aethanC1/LNA_board/Final Project Write Up.pdf

ECED 4460 Project Report
Low Noise Amplifier Design Using Planar TL Structures

Wrien By:
Benjamin Jarrin (B00846633) Aethan Cubi (B00877256)

Submied To:
Dr. David Chen
Dalhousie University
Halifax, Nova Scoa
25/04/2024

1

Objecve
Our objecve is to design a low-noise amplifier for a frequency of around 2.4GHz. This design is meant to be completed using a biasing network to bias the amplifying transistor. The second major component of the design is to use input and output matching networks to balance the impedances from the source and load into the amplifier. The outcome of this project will be a PCB board that will amplify a real RF signal.

Design Descripon
The low-noise amplifier in this project is meant to follow some design specificaons and meet the targets summarized in Table 1.

Table 1: Required Amplifier Parameters

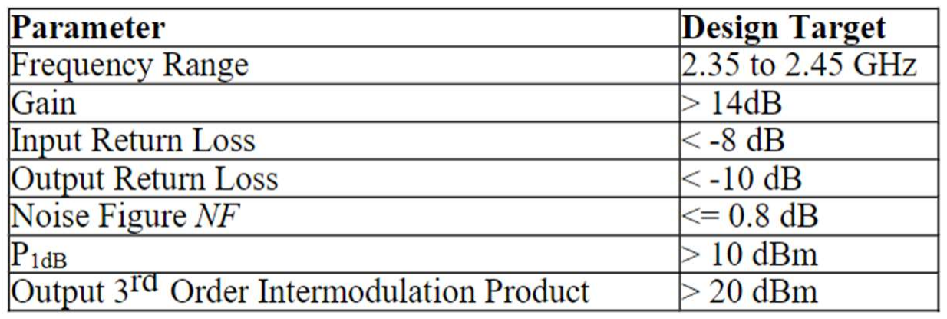
[picture p1: figure]

As Table 1 shows, the amplifier needs to have a gain of at least 14 dB. Each of these targets has been taken into consideraon in the final design by using the procedure learned in class. For this project the source, load, and characterisc impedance will be 50Ω.
The low-noise amplifier uses a SKY65050-372 n-channel transistor manufactured by SKYWORKS. The general block diagram of the system has been included in Figure 1 below.

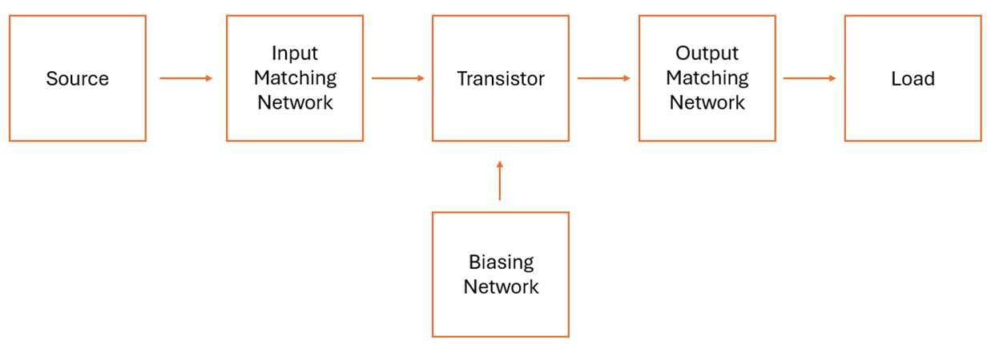
[picture p2: figure]

Figure 1: Amplifier Block Diagram
As seen in Figure 1, the transistor is the main component of the system as it is what generates the amplificaon. The source will generate the RF signal at 2.4GHz; the input matching network (IMN) then needs to convert the source impedance into a value that will result in the parameters being met. Similarly, the output matching network (OMN) will convert the load impedance into a desired value to meet the design target. Finally, the biasing network will be

2

designed to bias the transistor to its acve region and to a desired drain-source voltage and current.
The circuit schemacs which show the components of the amplifier more in detail have been included in Figure 2 below.

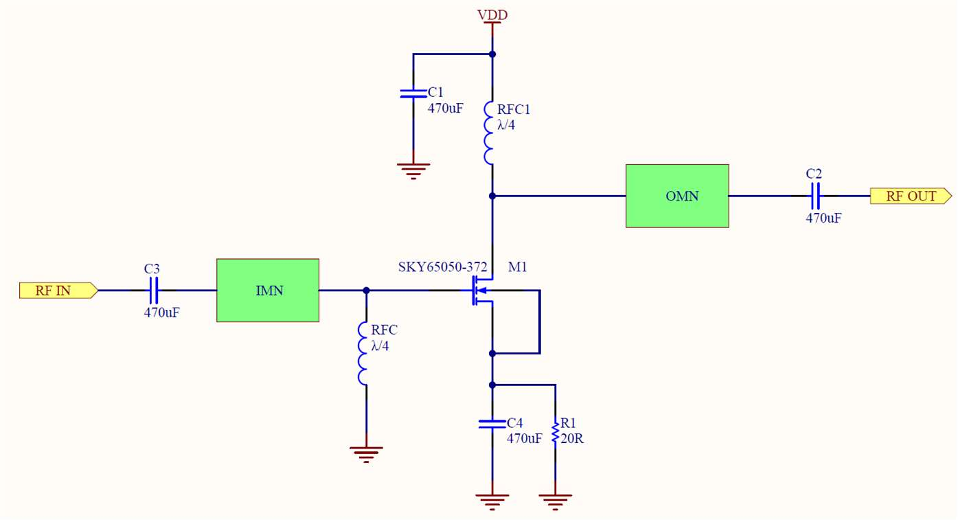
[picture p3: figure]

Figure 2: Amplifier Circuit Schemacs
In the schemacs above, the IMN, OMN, and RFC are replaced by microstrip transmission lines in the actual implementaon.
The value of VDD for this system has to be 4.3V, this will ensure that the transistor is biased to the desired condions. The funcon of the 20Ω resistor “R1” is to control the drain current into the desired value of 20mA. The funcon of the RFC is to let the DC current pass for biasing purposes while blocking the 2.4GHz RF signal. Finally, the capacitors have the funcon of decoupling, acng as AC ground, and blocking DC current.
For the design process, it was decided to aim for a target transducer gain of 18 dB. This was considered to be a good value as it was not in the lower limit, and it would result in an appropriate noise figure for the system.
ADS was used to aid in the design and opmizaon of the circuit. It was ulized to determine the exact biasing current of the transistor based on the transistor S parameters and biasing components.
Once the inial matching parameters were used, the IMN and OMN were added as microstrip lines to the design. The rest of the inial design that was in component form was redesigned into microstrip lines. The opmizaon goals were then set and the circuit was opmized.
Once the opmized circuit was created, the layout and symbol was created, following by adding a ground plane, vias, and lengths to add the input and output connector.

3

The symbol was then created into a Gerber file and sent into the technicians.

Procedures and Methodology
The design procedure started with the calculaon of the unilateral figure of the transistor using the MATLAB code in Appendix A. The calculaons revealed that a unilateral design was not possible which meant that another method had to be chosen. Aer consideraon of the different available opons, it was decided that the Available Power Gain method would be used as it allows one to choose a desired gain value and it does not have a unique soluon. This means that this method allows the choice of the most convenient value for the impedances to be matched based on other design parameters.
To have an organized approach, the design flow chart learned in class was used to design the amplifier. To determine whether the transistor is uncondionally stable, the proper calculaons were performed using the MATLAB code in Appendix A. The results were that it was not uncondionally stable, so the stability circles were calculated and ploed. Then, the noise consideraons were analyzed. The requirements were for a noise figure of less than 0.8 dB, so the MATLAB code in Appendix A was used to plot this noise circle. With the selected values, the calculated Noise Figure was 0.63 dB which is less than the maximum of 0.8 dB. Next, the available power gain method was used to plot the constant VSWR circle for a gain of 18 dB using the MATLAB code in Appendix A.
With all the parameters, the Smith chart in Figure 3 was obtained where the red circle is output stability, the green circle is the available power gain circle for a gain of 18 dB, and the pink circle is the noise circle.

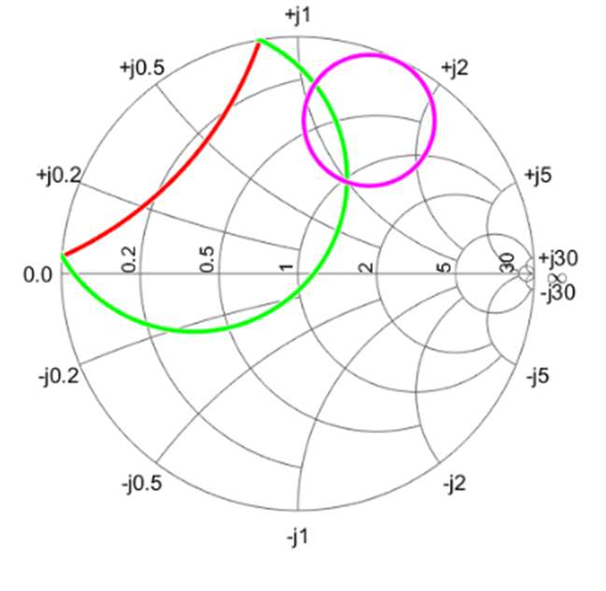
[picture p4: figure]

Figure 3: Smith Chart For IMN from MATLAB
This chart was also ploed in ADS using the simulaon feature to have more accurate results. The biasing network was created in ADS with ideal DC and AC blocks to create an output simulaon from the S-parameters and biasing network. From this (Appendix C), it was decided

4

that a good value for the input impedance which sasfies all the parameters was Zs = 0.6+j1.47. This means that the IMN will have to match the source impedance to the normalized value stated before.
From the Smith chart, the value of the source reflecon coefficient was measured which through the code in Appendix A allowed us to determine that the value for the load impedance would have to be Zl = 0.9774+j0.9215. This means that the OMN will have to transform the value of the normalized load impedance to the value menoned before. This point was also ploed in the Smith chart with the output stability circle to ensure the system remained stable, which it was.
The next step was to design the IMN and the OMN. The MATLAB code in Appendix A and the hand calculaons in Appendix B were used to obtain the matching networks.

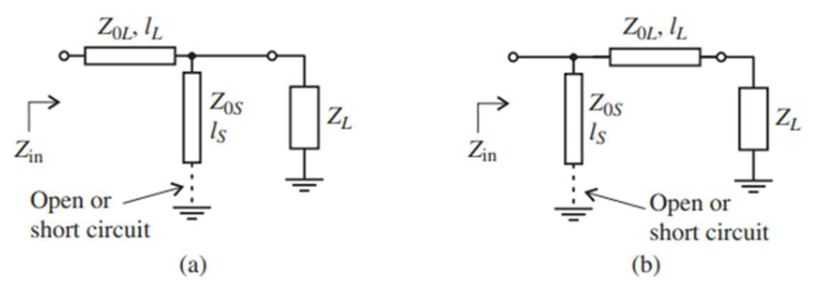
[picture p5: figure]

Figure 4: Microstrip Matching Networks Configuraons
For the IMN, configuraon b) of Figure 4 was used, while for the OMN configuraon a) was used. The purpose of this was to have the stubs as far as possible of the RFCs which would be close to the transistor. It was calculated that the length lL=3.425 cm and the length ls=0.924cm. Furthermore, it was chosen for ls to be short-circuited to have a shorter stub and to keep the integrity of the RF signal by allowing it to go to ground. For the OMN, IL=3.173cm, and ls=1.674cm. Similarly, the stub was chosen to be short-circuited to have a shorter stub and for signal integrity.
Finally, a non-linear analysis was performed using the MATLAB code in Appendix A to assess the last requirements which include intermodulaon distoron, harmonics, and gain compression. Since this amplifier consists only of one stage, the values for P1dB and IP3out are those of the first and only stage. These values are P1dB = 10.5 dBm and IP3out = 23.5 dBm which are higher than the minimum values. Furthermore, it was calculated that the dynamic range dR = 64.88 dB and the free spurious dynamic range df = 51.92 dB. Since the amplifier was designed for a gain of 18 dB, this means that the design would be operang within the linear region and intermodulaon distoron would not affect the output.

5

Implementaon and Measurements
The calculated Zs and ZL parameters were then implemented into the line calculaon feature in ADS. The network shown in Appendix C is the network created from these values. The opmizaon of the circuit through the goals in Appendix C changed the IMN lengths to lL= 2.742 cm and ls=0.493 cm. The opmizaon goals also changed the OMN lengths to IL=2.9235 cm, and ls=2.659 cm.
In addion, the transion from a theorecal circuit to a real microstrip line circuit resulted in capacitors being added between each stub end and ground except the input quarter wavelength stub. This is to create an AC ground across the capacitors.
The transistor was the main component being added to the board. This requires building the pads from the data sheet on ADS and providing the appropriate gaps for the component to be soldered onto the board. The gap measurements for all parts were measured out based on the gap sizes of the resistors and capacitors. The resistors and capacitors were chosen based on the size in stock and the impedances available. These were then implemented into the circuit with gaps and pads for the components.
Once the amplifier values where calculated and the PCB design was performed using ADS, the PCB was printed. Then, the discrete components like the transistor and capacitors were soldered into the board. A photo of the final physical product has been included in Figure 5 below.

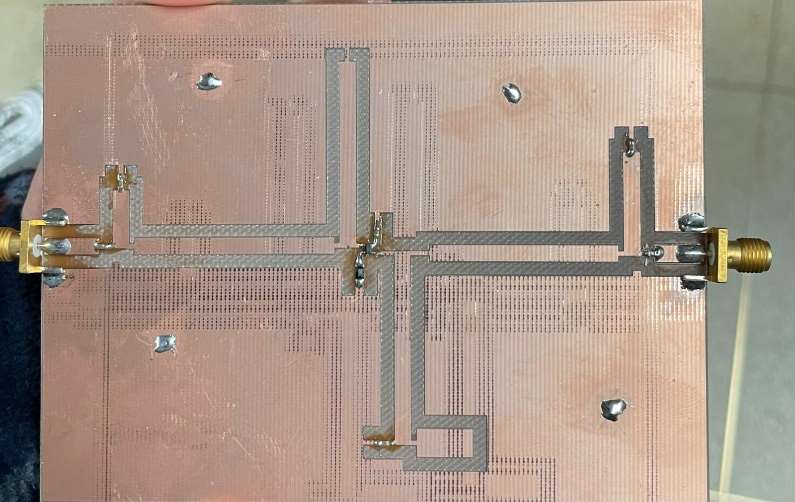
[picture p6: figure]

Figure 5: Final Physical Product
On the tesng day, the circuit was tested in a lab environment using a special signal generator and oscilloscope to measure the frequency response of the amplifier with respect to S21 (gain), and S11 (input return loss) within a range of frequencies from 0.3MHz to 8.5GHz. Furthermore, the circuit was biased to 4.3 VDC with a DC power supply.

6

Aer tesng, the data was gathered and the graphs generated have been included in the figures below.

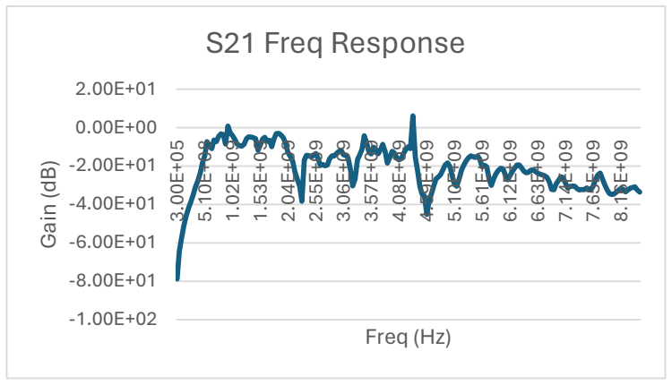
[picture p7: figure]
Freq (Hz); S21 Freq Response

Figure 6: S21 Frequency Response

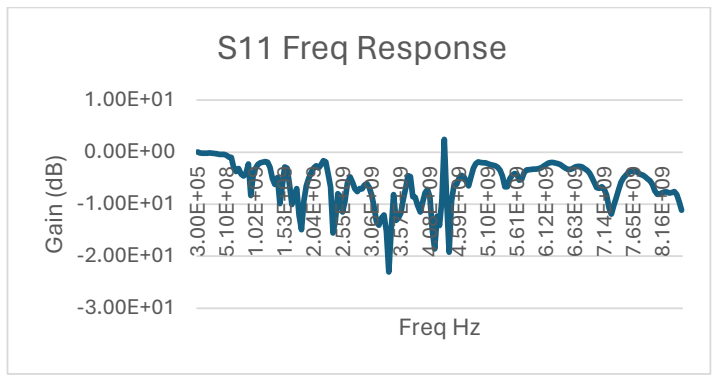
[picture p8: figure]
Freq Hz; S11 Freq Response

Figure 7: S11 Frequency Response
As seen in figure 6, the graph for the gain (S21) shows that in the design target frequency range of 2.35 to 2.45 GHz the gain is a negave dB value. This means that in the linear scale, the gain was less than 1 and greater than zero which means that the RF signal was aenuated instead of amplified. However, the graph shows that for a frequency of 4.34 GHz, the RF signal experienced a gain of 6.15 dB. These results were unexpected because the amplifier was designed to produce a gain at a frequency of 2.4 GHz, but the actual results showed there was no amplificaon at this frequency and there was at 4.34 GHz. The possible reasons for this behavior will be discussed in the next secon.
As seen in figure 7, the graph for the input return loss (S11) reveals that this parameter has a negave dB value throughout the target design frequency range of 2.35 to 2.45 GHz. The data also shows that at a frequency of 2.47 GHz S11 = -8 dB and at a frequency of 2.51 GHz
S11 = -8.52 dB which means that the requirement for the input return loss was achieved at frequencies very close to the target 2.4GHz.

2.00E+01 3.00E+05 5.10E+08 1.02E+09 1.53E+09 2.04E+09 2.55E+09 3.06E+09 3.57E+09 4.08E+09 4.59E+09 5.10E+09 5.61E+09 6.12E+09 6.63E+09 7.14E+09 7.65E+09 8.16E+09 Gain ⁽dB⁾

1.00E+01 Gain ⁽dB⁾ | 3.00E+05 5.10E+08 1.02E+09 1.53E+09 2.04E+09 2.55E+09 3.06E+09 3.57E+09 4.08E+09 4.59E+09 5.10E+09 5.61E+09 6.12E+09 6.63E+09 7.14E+09 7.65E+09 8.16E+09

7

Analysis
As it was discussed in the implementaon and measurement secon, the final design and tesng did not yield the results expected in terms of gain. For the desired operang frequency of 2.4GHz, the RF signal was aenuated instead of amplified. Furthermore, there was an amplificaon of 6.15 dB at a frequency of 4.34 GHz. There could have been mulple factors that led to the deviaon between the theorecal values and real results. Firstly, it is not believed that the deviaons were due to a biasing issue. This is because when tesng the circuit, the voltage between the gate and the source of the MOSFET was close to 3VDC which was what it was designed for. Furthermore, the biasing voltage was swept across a range of acceptable values without having any success in achieving the desired gain values.
Aer ruling out the biasing as a possible cause of the inability to obtain the desired gain, it is hypothesized that the reason for this could have been a combinaon of the matching network design and the PCB design for RF signal integrity. There is a possibility there was a mistake in the design of the matching networks when using the MATLAB code in Appendix A or the hand calculaons in Appendix B. If a major mistake was made in the design of the matching networks, this means that the input and output impedances required for the transistor to generate the desired gain were not achieved and another value for the gain was obtained. This could also explain why there was gain observed at 4.34GHz instead of 2.4GHz.
The second possible reason has to do with the design of the PCB. RF design is a complex subject as the PCB needs to have mulple consideraons for signal integrity. These factors include shielding along the RF signal traces and mulple vias in the ground plane. Both of these are done to preserve the quality of the RF signal. Due to the learning stage we are at, these other consideraons were not taken into account. As a result, the RF signal was not correctly handled in the PCB leading to scaering and addional aenuaon within the board.
Another hypothecal reason could be the secons added to the board to accept the SMA connectors did not take into account the wavelength of the input frequency. This shortcoming and misunderstanding of how the input and output interact with the circuit was a highly probable reason for the circuit not performing. In the next iteraon of the board we would aach the LNA to be on a wavelength stub to ensure that an integral signal is being input onto the board.
This change would change the length of the connecng stub to 12 mm to 0 mm. By aaching the SMA connector directly to the end of the circuit the wavelength will be inserted without inserng an inaccuracy which un-validated the matching network.
Another improvement in the next iteraon of the circuit would be the removal of the extra connecng lines between stubs. The most accurate way to connect each component of the

8

network is to have them T up directly next to eachother. In the circuit designed we had a space with a thin wire connecng the components, this wire may have brought unforeseen error to our circuit.
The last main component that was missing from the constructed PCB was the fact that we were unable to achieve a simulated gain of more than 8dB. The simulaons outcome from the opmizaons didn’t allow for us to be able to simulate the correct gain. The theorecal gain was calculated to be 18dB but did not match ADS. To fix this error we would allow more components of the circuit to be modified to hopefully allow ADS to achieve a posive gain. Another possible soluon to these problems would be to modify the weights or goals themselves more than what has already been changed.

Conclusion
The design of an LNA board is complicated, but also an amazing learning experience. We learned the power of ADS and how it can be applied to help create a gain, but with powerful compung comes complexity. The difference between our theorecal circuit, gains, ADS, and the tested circuit board posed different challenges along the way. We believe we did accurate inial calculaons of the circuit, and in the next iteraon would put a larger focus and more me on the fine tuning within the ADS soware. The key findings of the circuit are shown below.

Table 2: Final Results
| Goal | Achieved
Biasing Voltage | 3.0V | 3.2V
Biasing Current | 20mA | 20mA +- 5mA
S11 | -8 dB < | -8.52 dB
Gain at 4.3 GHz | | 6.15 dB

The low noise amplifier design procedure was followed to achieve an amplifier based on theorecal calculaons. The final product was achieved by designing a DC biasing network, stability network design, impedance matching network design, layout, ADS simulaons and opmizaons, nonlinear analysis, Gerber file generaon, prototype building, and tesng and verificaon of the final results.
Even though the final product did not achieve the final amplificaon objecves, the process involved in designing the amplifier was extremely valuable to understanding the process and theory learned in class through its applicaon. This process also was valuable in the development of crical thinking skills and problem-solving through creavity and the use of theorecal concepts.

9

Finally, both group members contributed equally to the contribuon of the project. Tasks were divided equally to make sure understanding of the topics were achieved and collaboraon was crual to achieve the final design.

Appendix A: MATLAB Code

%Transistor Parameters
%Freq=2.393675GHz
clc
clear all
disp(['Transistor Parameters']) s11dBmag=-2.86;
s11dBph=-108.74;
s12dBmag=-25.24;
s12dBph=26.54;
s21dBmag=15.58;
s21dBph=91.14;
s22dBmag=-3.21;
s22dBph=-52.01:;
s11 = 10^(s11dBmag/20)*exp(s11dBph/180 * pi* 1i); % Convert from dB to linear scale s12 = 10^(s12dBmag/20)*exp(s12dBph/180 * pi * 1i);
s21 = 10^(s21dBmag/20)*exp(s21dBph/180 * pi * 1i);
s22 = 10^(s22dBmag/20)*exp(s22dBph/180 * pi * 1i);
disp(['s11 = ', num2str(abs(s11)), '<', num2str(angle(s11)*180/pi)]) disp(['s12 = ', num2str(abs(s12)), '<', num2str(angle(s12)*180/pi)]) disp(['s21 = ', num2str(abs(s21)), '<', num2str(angle(s21)*180/pi)]) disp(['s22 = ', num2str(abs(s22)), '<', num2str(angle(s22)*180/pi)])
delta = ((s11*s22) - (s12 * s21)); %complex
k = (1 - abs(s11*s11) - abs(s22 * s22) + abs(delta * delta))/(2 * abs(s12*s21));

%Unilateral Design Check
disp(['Unilateral design considerations'])
GTU = 18;
U = (abs(s12*s21*s11*s22))/((1-abs(s11^2))*(1-abs(s22^2))); MD = 1/(1+U)^2;
LD = 1/(1-U)^2;
MDdB = 10*log10(MD);
LDdB = 10*log10(LD);
Lessval = (MDdB/GTU)*100
Plusval = (LDdB/GTU)*100
%Stability Considerations
%For Output Stability
disp(['Stability Considerations'])
Cout = (conj(s22 - conj(s11)*delta))/ (abs(s22 * s22) - abs(delta * delta)); Coutmag = abs(Cout)
Coutph = angle(Cout)*180/pi
Coutc = [(real(Cout)), (imag(Cout))];
rout = abs(s12 * s21)/ ( abs(abs(s22 * s22) - abs(delta * delta))) %For Input Stability

10

Cin = (conj(s11 - conj(s22)*delta))/ (abs(s11 * s11) - abs(delta * delta)); Cinmag = abs(Cin)
Cinph = angle(Cin)*180/pi
Cinc = [real(Cin), imag(Cin)];
rin = abs(s12 * s21)/ ( abs(abs(s11 * s11) - abs(delta * delta)))

%Available Power Gain Method
disp(['Available Power Gain Method'])
GAdB = 18; %Target gain in dB
GA = 10^(GAdB/10); %Target gain in linear scale
ga = GA/(abs(s21))^2;
dga = (ga*conj(s11-(delta*conj(s22))))/(1+(ga*(abs(s11*s11)-abs(delta*delta)))); dgac = [real(dga), imag(dga)];
numrga = sqrt(1-(2*k*ga*abs(s12*s21))+(ga*ga*(abs(s12*s21))^2));
denrga = abs(1+(ga*(abs(s11*s11)-abs(delta*delta))));
disp(['dga = ', num2str(abs(dga)), '<', num2str(angle(dga)*180/pi)]) rga = numrga/denrga

%Noise Figure Code
Gsmag=0.7 %insert magnitude of gammaS
Gsphase=60.28 %insert phase of gammaS in deg Gs = Gsmag*exp(1i*deg2rad(Gsphase));
Goptmag = 0.745;
Goptph = 65;
Gopt = 10^(Goptmag/20)*exp(Goptph/180 * pi* 1i) Fmin = 10^(0.39/10); %dB
Rn = 8; %this gets divided by 50 to become 0.16
Zo = 50;
F = (Fmin + (4 * Rn / Zo) * (abs((Gs-Gopt)*(Gs-Gopt))) / ((1-abs(Gs * Gs)) * (abs(1+Gopt))*(abs(1+Gopt))));
NF = 10 * log10(F) %should be less than 0.8
Fk = 10^(0.8/10);
Qk = (abs(1 + Gopt) * abs(1 + Gopt)) * (Fk-Fmin)/(4 * Rn / Zo); % Where in circle dfk = Gopt/(1 + Qk) %Center of Circle
df = [real(dfk), imag(dfk)];
rfk = sqrt(((1-(abs(Gopt))^2)*Qk)+Qk^2)/(1+Qk)

%Biasing Calculations
syms Rs
VDS=3; %volts
ID = 0.02; %in Amps
Vth = -0.8; %in volts
gm = 0.08; %in S
EQ = (ID*ID*Rs^2)+(2*Vth*ID*Rs)+((Vth^2)-((4*ID^2)/(gm^2))) R1=solve(EQ)
VDD = VDS+(R1(1)*ID)

%plotting circles on smith chart
h = smithplot
hold on;
viscircles(Cinc, rin, 'Color','r') %input stability red

11

%viscircles(Coutc, rout, 'Color', 'b') %output stability viscircles(dgac, rga, 'Color', 'g') %gain circle viscircles(df, rfk, 'Color', 'm') %Noise circle

%Output matching network
%Method 1
rsmag=0.7 %insert magnitude of gammaS
rsphase=60.28 %insert phase of gammaS in deg
rs = rsmag*exp(1i*deg2rad(rsphase));
disp(['gammaS = ', num2str(abs(rs)), '<', num2str(angle(rs)*180/pi)]) gammaout = s22 + ((s21*s12*rs)/(1-(s11*rs)));
gammaL = conj(gammaout);
Zl = (1+gammaL)/(1-gammaL)
%Input matching network
freq = 2.4e9;%frequency in Hz c=299792458; %speed of light m/s wl=1 %(c/freq)*100
ls1=0.2742*wl
ls2=(0.337+(0.5-0.4372))*wl
ls1rev = (0.437-0.1623)
lst1=(0.5-0.426)*wl
lst2=(0.5-0.074)*wl %both for short end stub for 1 als1=(ls1*360)/0.5
als2=(ls2*360)/0.5
als1rev = (ls1rev*360)/0.5
alst1=(lst1*360)/0.5
alst2=(lst2*360)/0.5
%Output matching network continuation lL1=0.162+(0.5-0.408)
lL2=0.162-0.0917
lstl1=0.5-0.366
lstl2=0.5-0.162 %both for short end stub alL1=(lL1*360)/0.5
alL2=(lL2*360)/0.5
alstl1=(lstl1*360)/0.5
alstl2=(lstl2*360)/0.5

%Non-linear Analysis
B = 6e9;%bandwidth (Hz)
G = 18; %gain used
%noise figure is NF allready in dB
kT = -173.8; %This is 10*log10(kT) at 300K X = 3; %SNR in dB
Pout1dB = 10.5; %dBm
IP3out = 23.5; %dBm
Pnout = kT+(10*log10(B))+G+NF; %dBm Poutmds = Pnout + X; %dBm
dr = Pout1dB-Poutmds %in dB
df = (2/3)*(IP3out-Poutmds) %in dB

12

Appendix B: Hand Calculaons

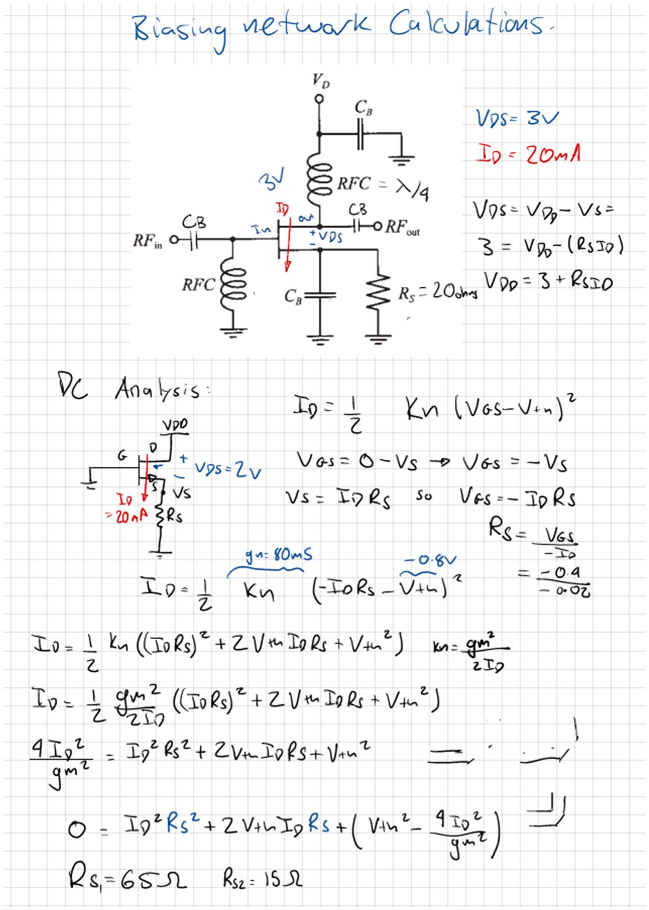
[picture p9: figure]
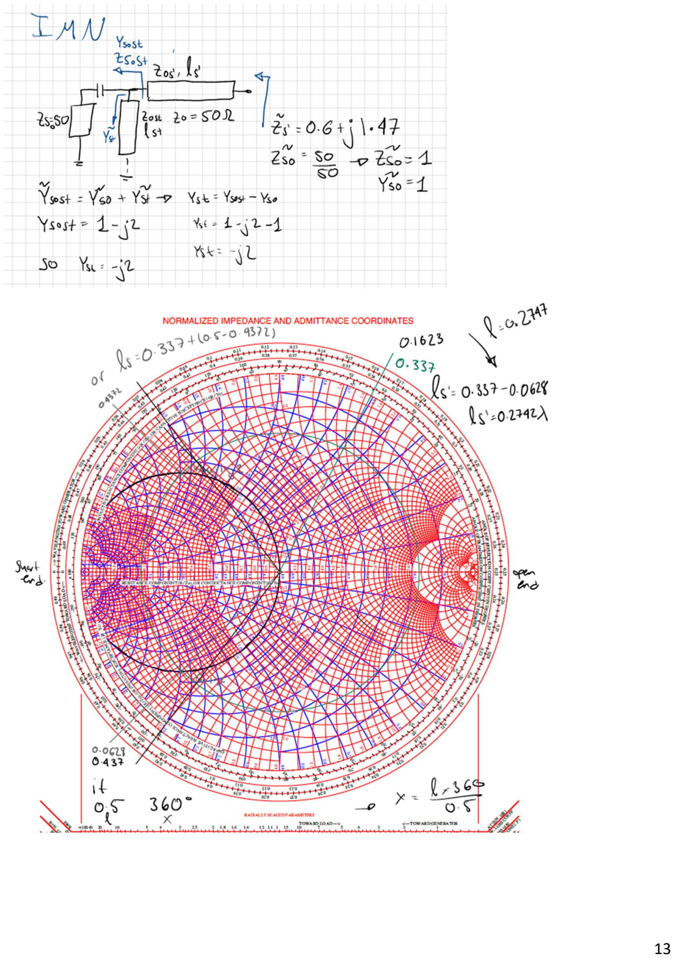
[picture p10: page 14]

13

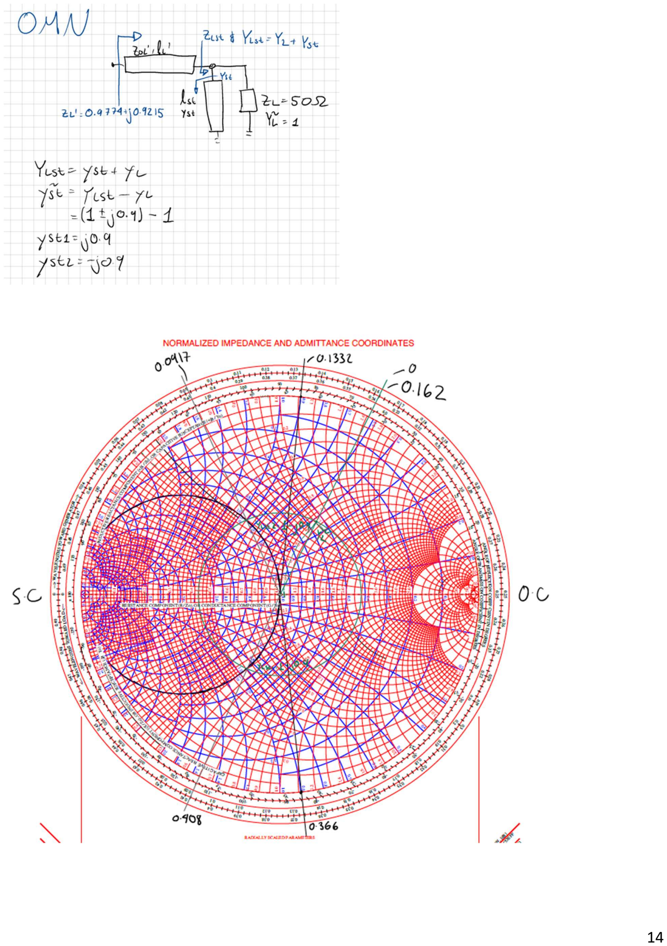
[picture p11: page 15]

14

15

## Appendix C

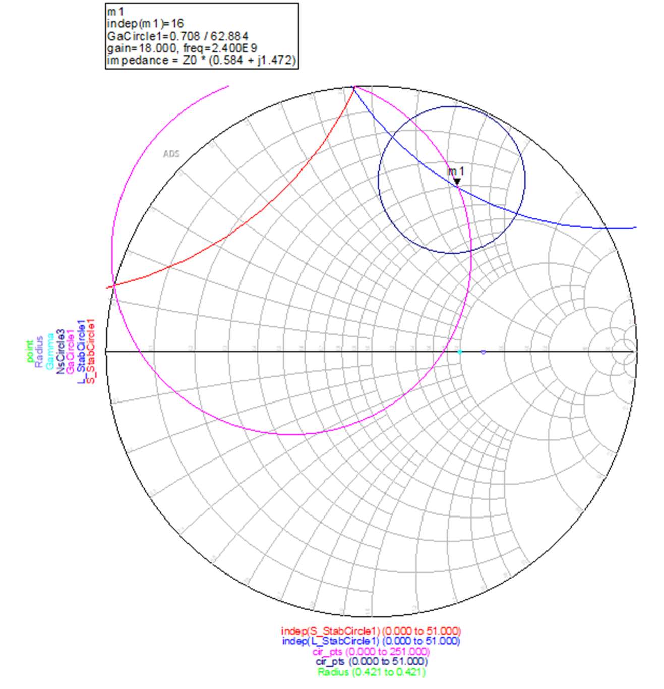
[picture p12: figure]

Figure 8: ADS smith chart

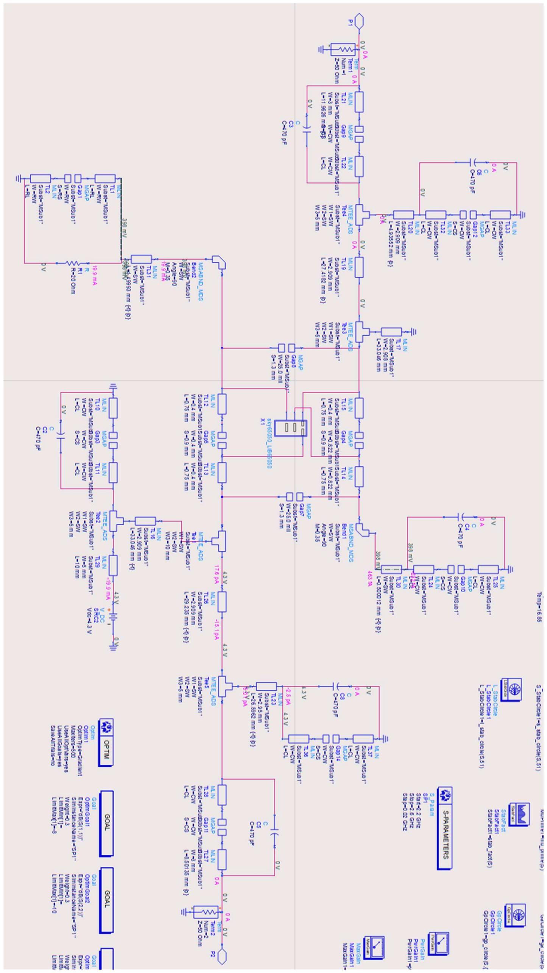
[picture p13: figure]

16

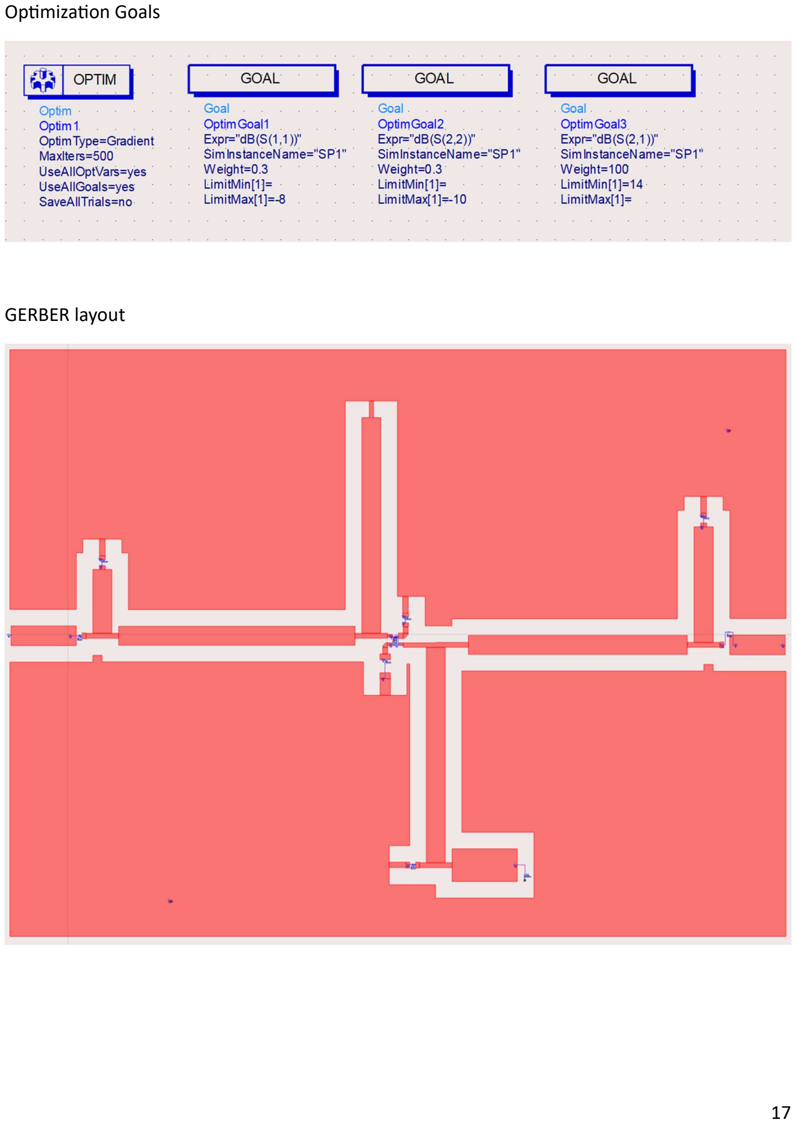
[picture p14: page 18]

17

Opmizaon Goals

GERBER layout

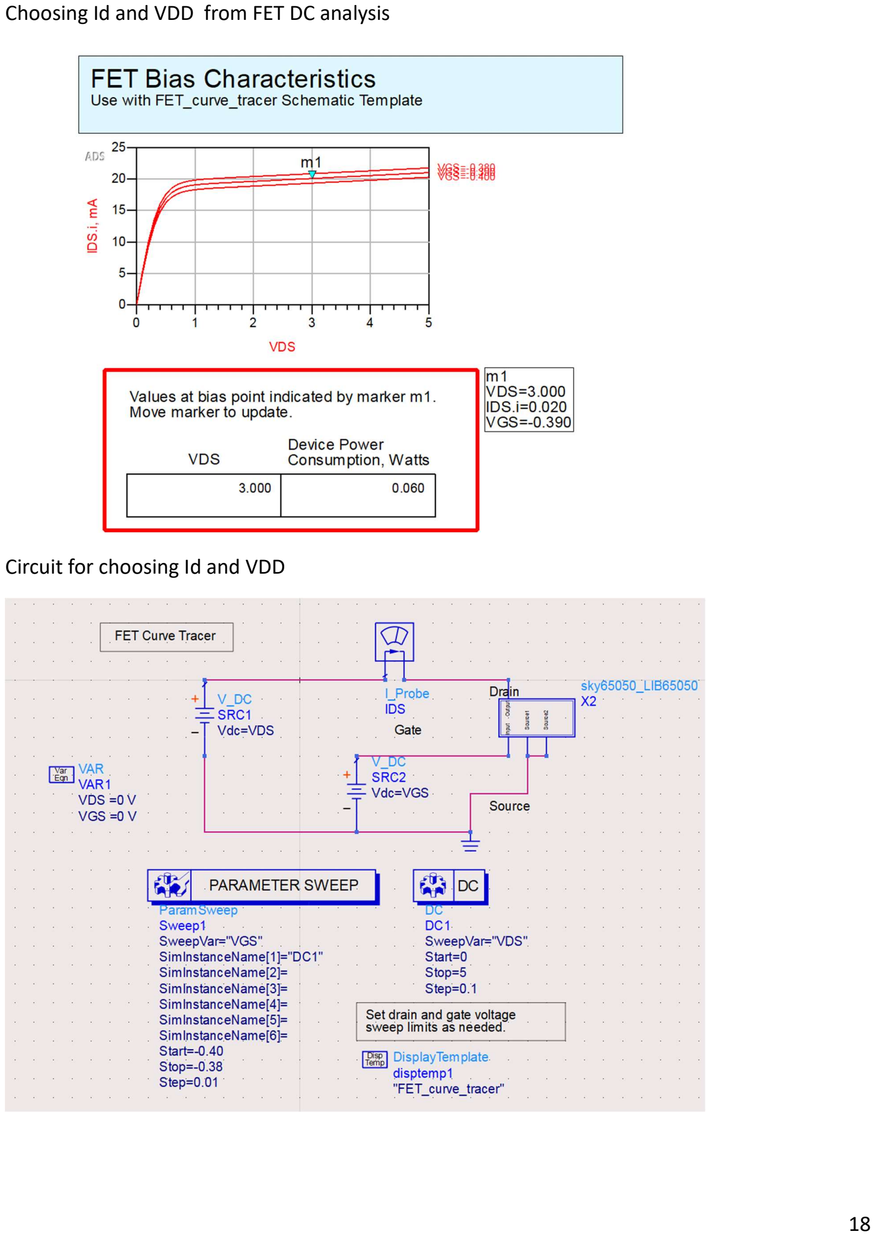
[picture p15: page 19]

18

Choosing Id and VDD from FET DC analysis

Circuit for choosing Id and VDD

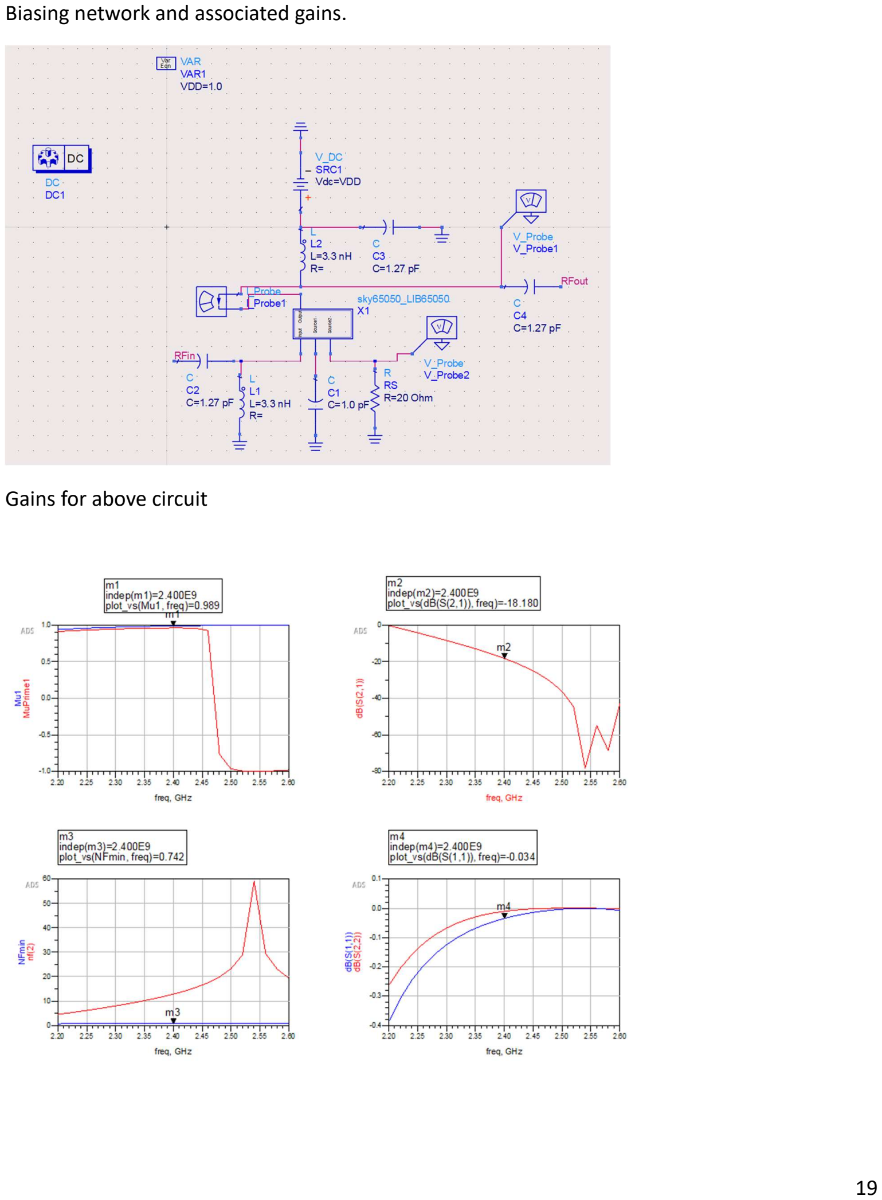
[picture p16: page 20]

19

Biasing network and associated gains.

Gains for above circuit
