aethanC1/LNA_board/(commit log)

2024-12-28 Matlab code for smith chart calculations
    this code calculated the lengths of different stubs on the board to achieve the desired gain
2024-12-28 Picture of the manufactured LNA board
